Vindaomeo/retropixel/docs/hello_rainbow.gif

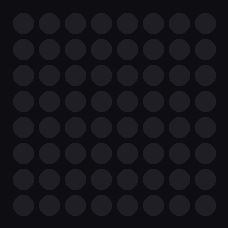
docs/hello_rainbow.gif
