Vindaomeo/retropixel/docs/smiley.gif

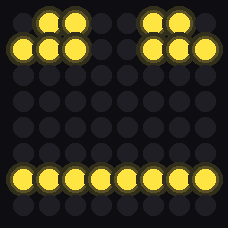
docs/smiley.gif
