Vindaomeo/retropixel/pcb/LED_Matrix_16x16_2L/LED_Matrix_16x16_2L.step

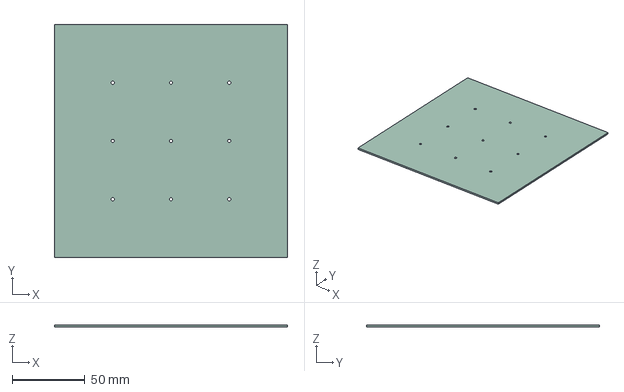
[picture p3: CAD file, 2026-10-02]
pcb/LED_Matrix_16x16_2L/LED_Matrix_16x16_2L.step
160.0 x 160.0 x 1.51 mm
