Vindaomeo/retropixel/pcb/LED_Matrix_16x16_Rahmen.stl

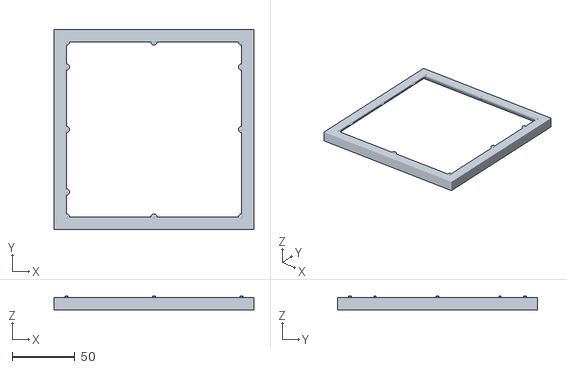
[picture p4: CAD file, 2026-10-02]
pcb/LED_Matrix_16x16_Rahmen.stl
160.0 x 160.0 x 11.4
