Vindaomeo/retropixel/pcb/LED_Matrix_16x16_Lichtgitter.stl

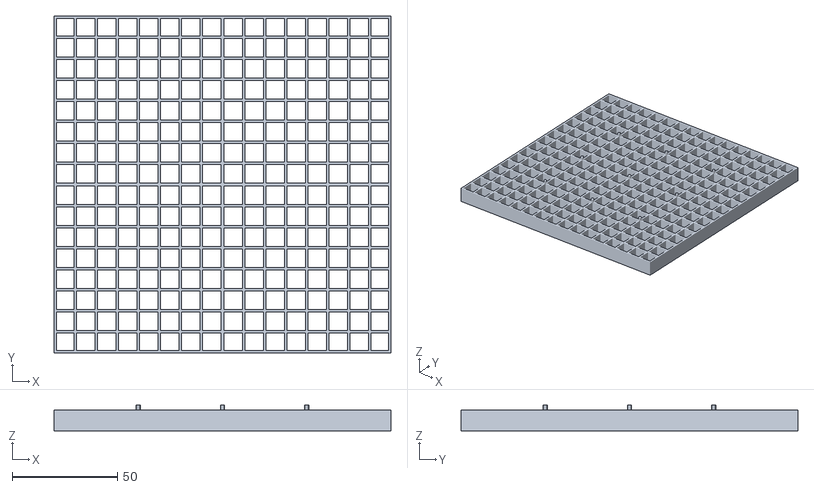
[picture p5: CAD file, 2026-10-02]
pcb/LED_Matrix_16x16_Lichtgitter.stl
160.0 x 160.0 x 12.2
