Vindaomeo/retropixel/pcb/LED_Matrix_16x16_Lichtgitter_Test3x3.stl

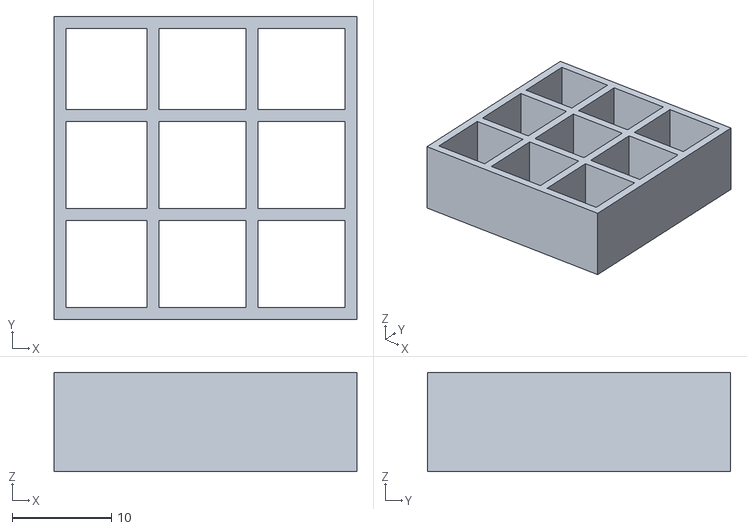
[picture p6: CAD file, 2026-10-02]
pcb/LED_Matrix_16x16_Lichtgitter_Test3x3.stl
30.6 x 30.6 x 10.0
