Vindaomeo/retropixel/pcb/LED_Matrix_16x16_2L/LED_Matrix_16x16_2L.kicad_pcb

## KiCad design pcb/LED_Matrix_16x16_2L/LED_Matrix_16x16_2L.kicad_pcb (2026-10-02)

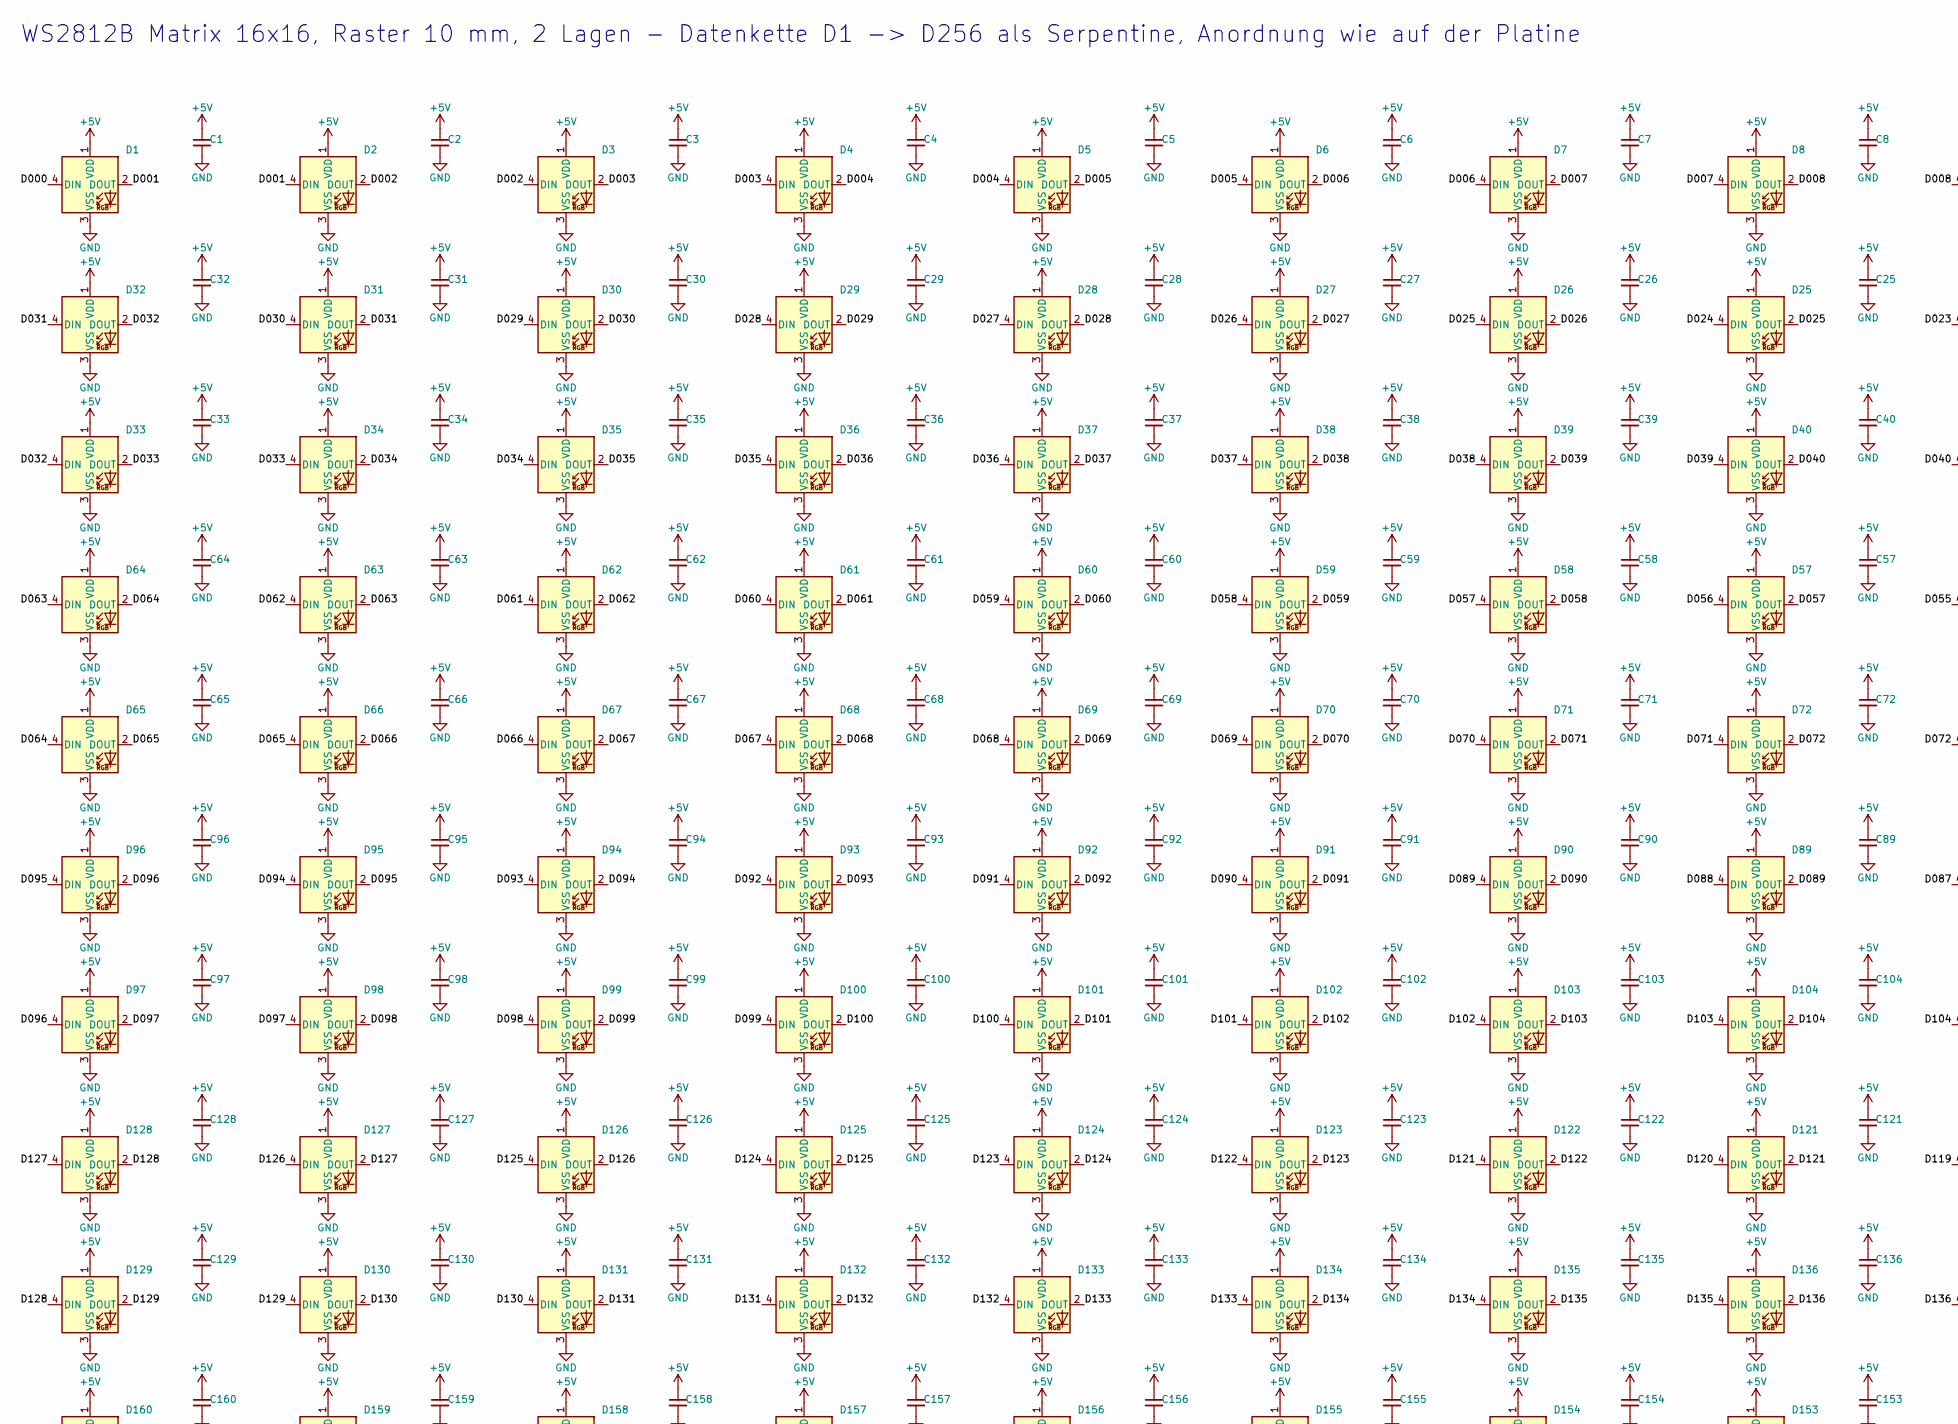
[picture p7: schematic LED_Matrix_16x16_2L.kicad_sch, WS2812B Matrix 16x16, Raster 10 mm, 2 Lagen, part in row 1, column 1]

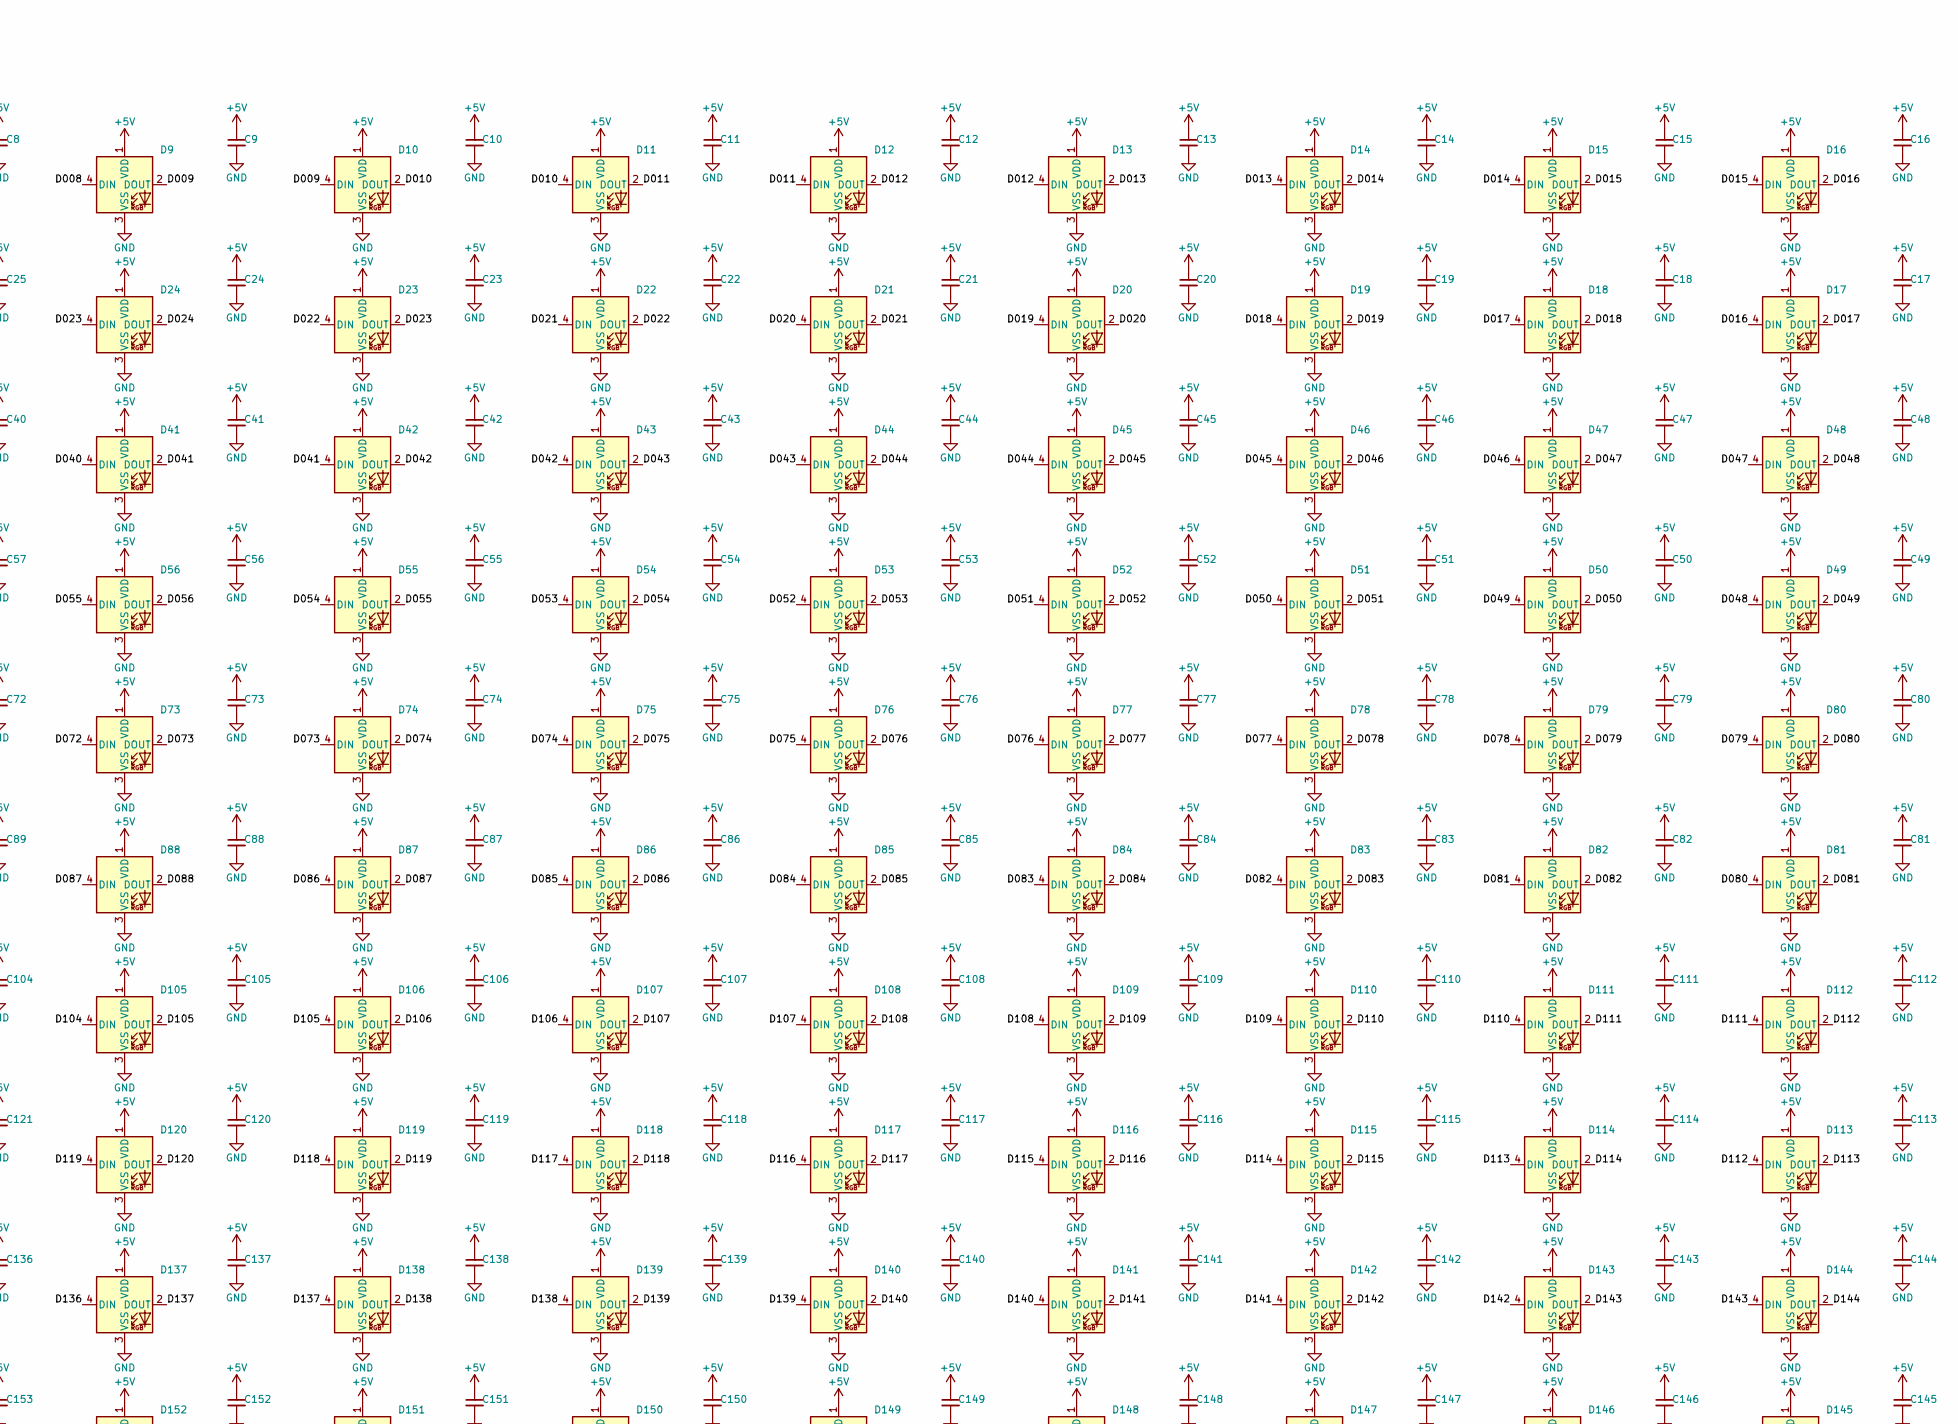
[picture p8: schematic LED_Matrix_16x16_2L.kicad_sch, WS2812B Matrix 16x16, Raster 10 mm, 2 Lagen, part in row 1, column 2]

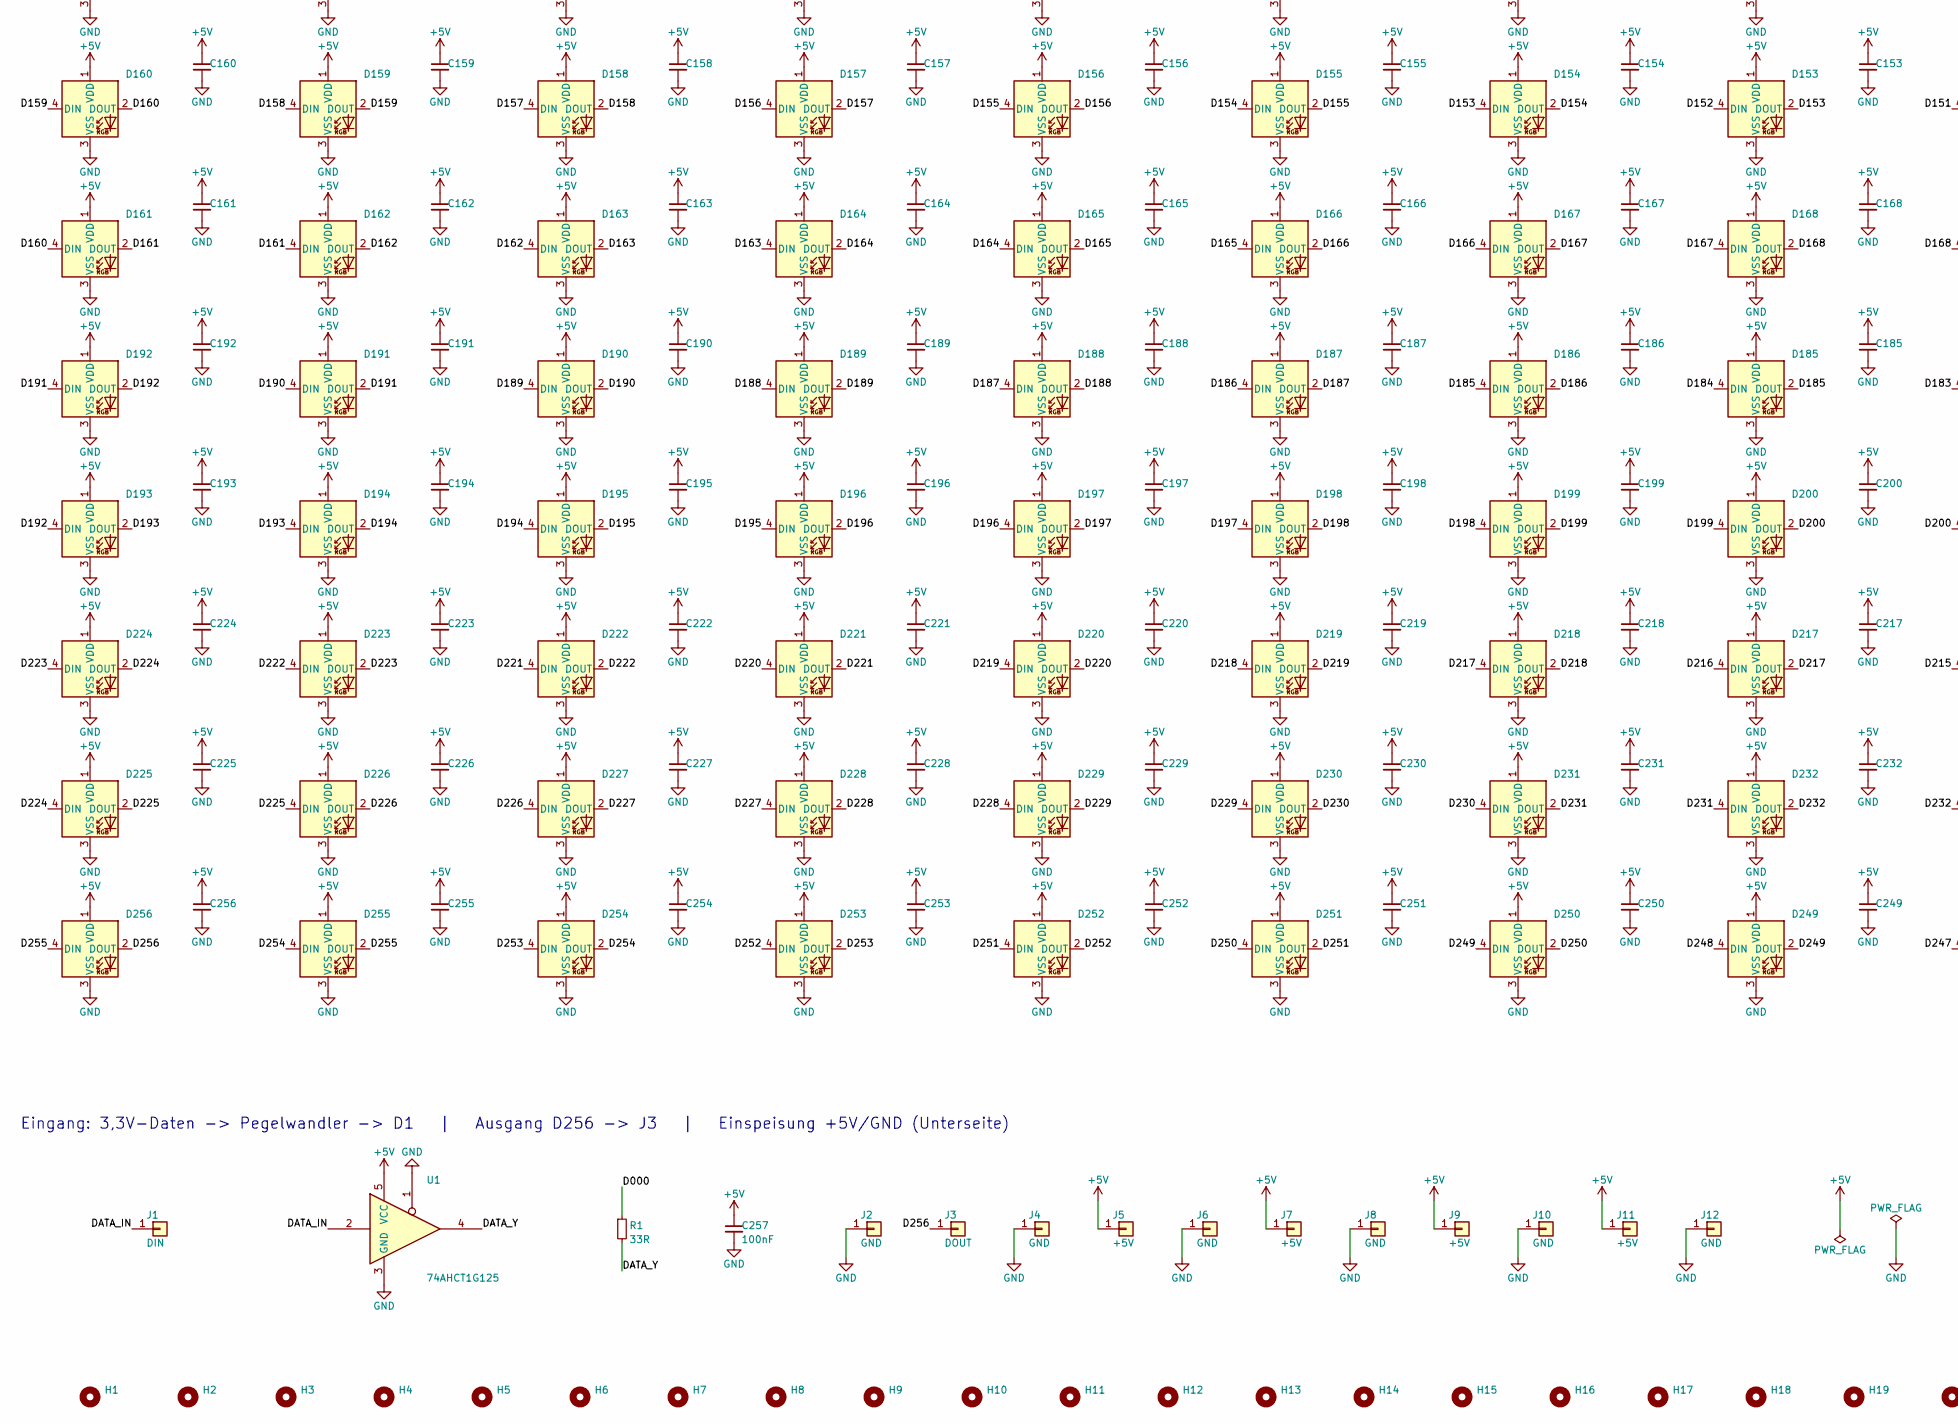
[picture p9: schematic LED_Matrix_16x16_2L.kicad_sch, WS2812B Matrix 16x16, Raster 10 mm, 2 Lagen, part in row 2, column 1]

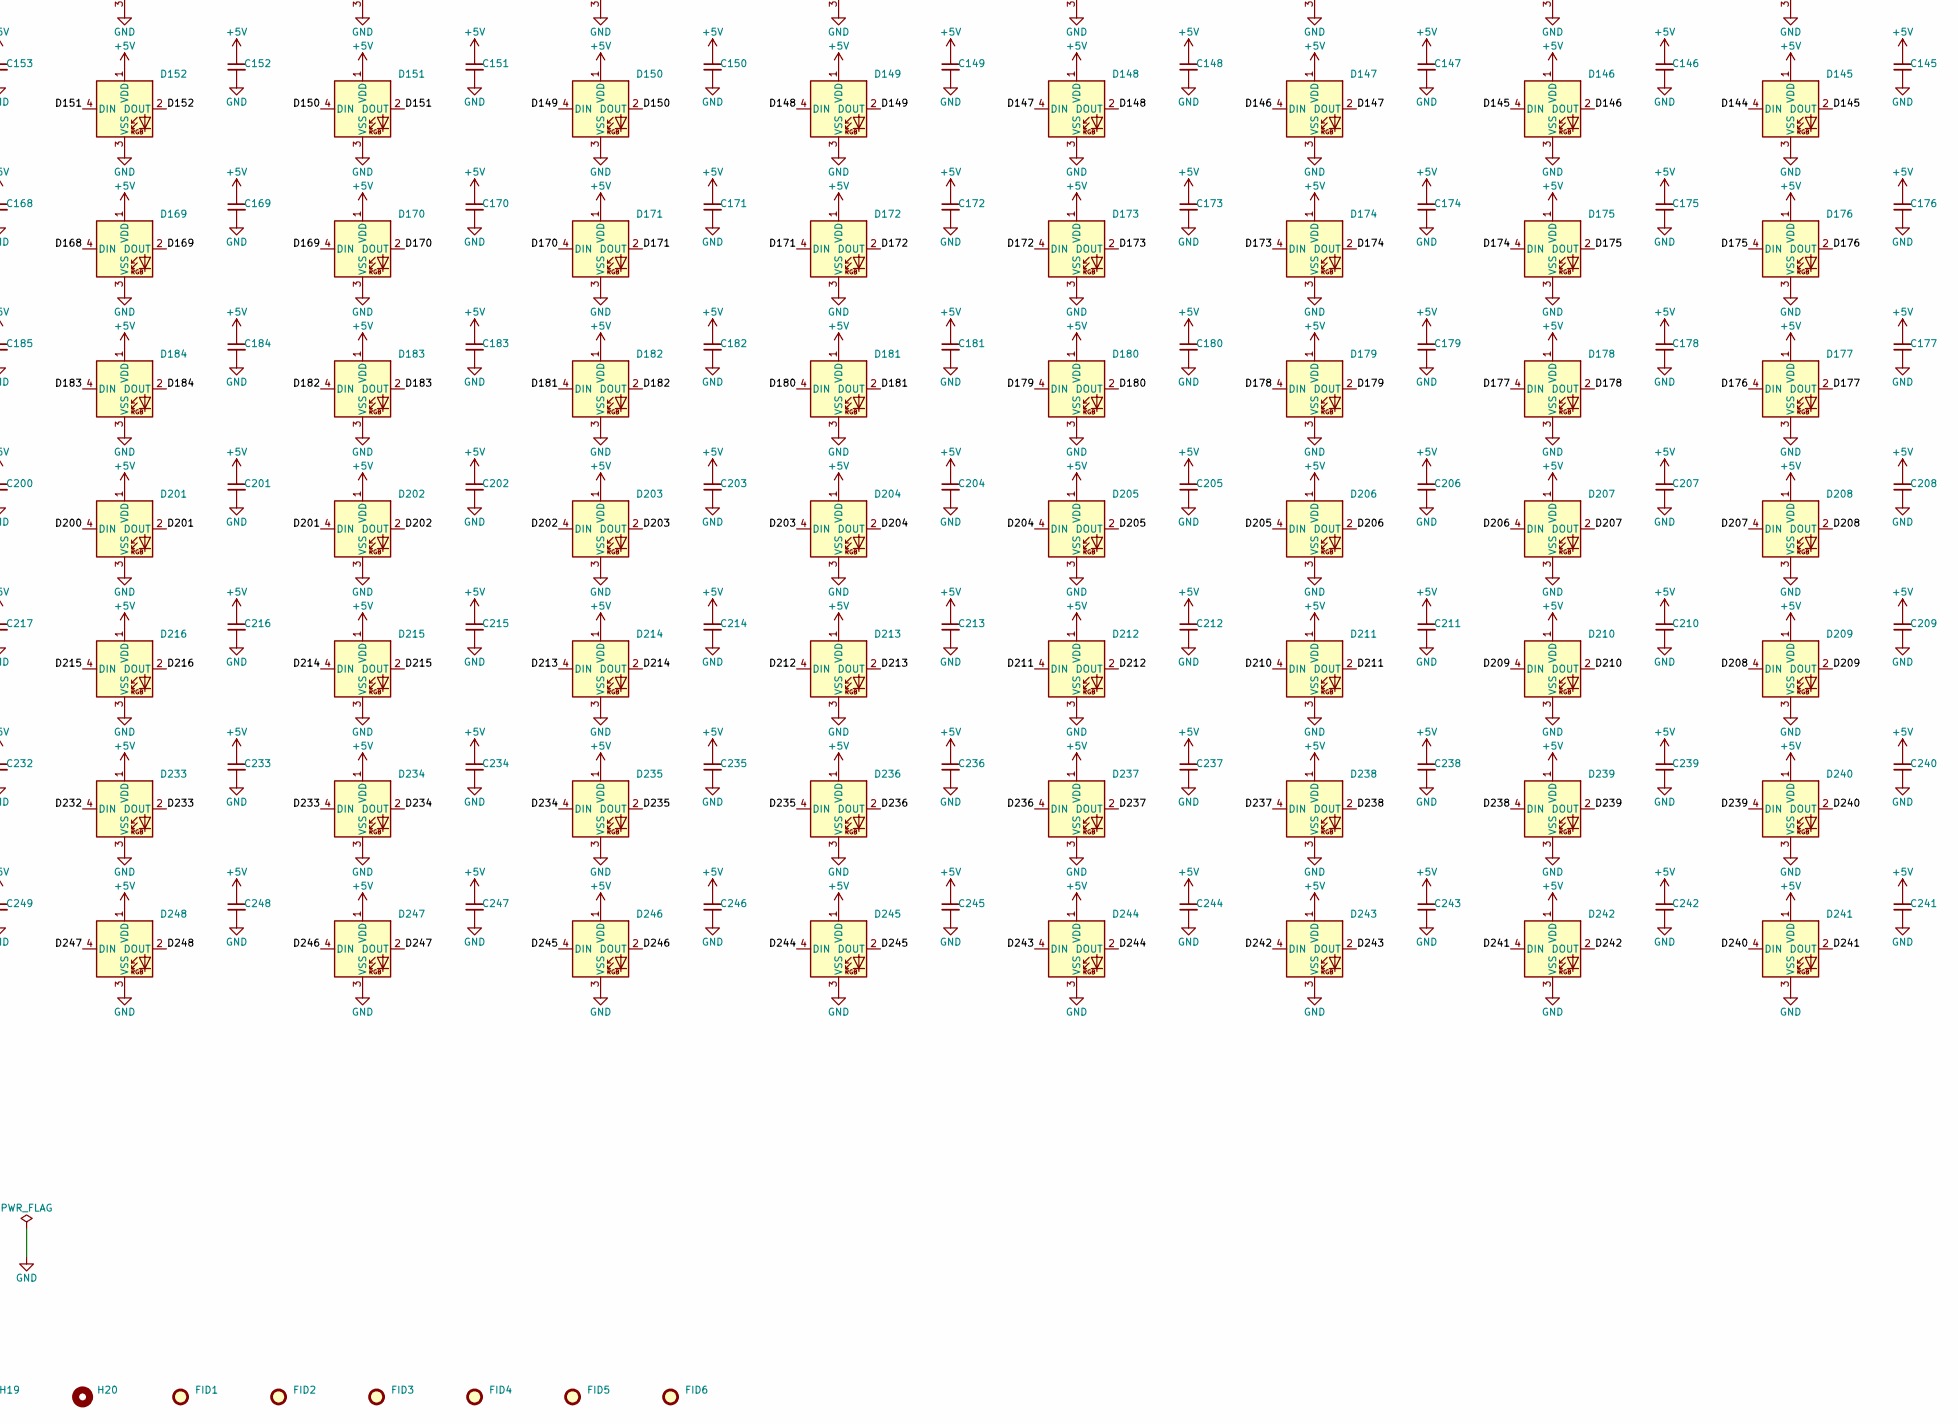
[picture p10: schematic LED_Matrix_16x16_2L.kicad_sch, WS2812B Matrix 16x16, Raster 10 mm, 2 Lagen, part in row 2, column 2]

Parts:
C1, C2, C3, C4, C5, C6, C7, C8, C9, C10, C11, C12, C13, C14, C15, C16, C17, C18, C19, C20, C21, C22, C23, C24, C25, C26, C27, C28, C29, C30, C31, C32, C33, C34, C35, C36, C37, C38, C39, C40, C41, C42, C43, C44, C45, C46, C47, C48, C49, C50, C51, C52, C53, C54, C55, C56, C57, C58, C59, C60, C61, C62, C63, C64, C65, C66, C67, C68, C69, C70, C71, C72, C73, C74, C75, C76, C77, C78, C79, C80, C81, C82, C83, C84, C85, C86, C87, C88, C89, C90, C91, C92, C93, C94, C95, C96, C97, C98, C99, C100, C101, C102, C103, C104, C105, C106, C107, C108, C109, C110, C111, C112, C113, C114, C115, C116, C117, C118, C119, C120, C121, C122, C123, C124, C125, C126, C127, C128, C129, C130, C131, C132, C133, C134, C135, C136, C137, C138, C139, C140, C141, C142, C143, C144, C145, C146, C147, C148, C149, C150, C151, C152, C153, C154, C155, C156, C157, C158, C159, C160, C161, C162, C163, C164, C165, C166, C167, C168, C169, C170, C171, C172, C173, C174, C175, C176, C177, C178, C179, C180, C181, C182, C183, C184, C185, C186, C187, C188, C189, C190, C191, C192, C193, C194, C195, C196, C197, C198, C199, C200, C201, C202, C203, C204, C205, C206, C207, C208, C209, C210, C211, C212, C213, C214, C215, C216, C217, C218, C219, C220, C221, C222, C223, C224, C225, C226, C227, C228, C229, C230, C231, C232, C233, C234, C235, C236, C237, C238, C239, C240, C241, C242, C243, C244, C245, C246, C247, C248, C249, C250, C251, C252, C253, C254, C255, C256, C257: 100nF; C_0402_1005Metric; LCSC C1525
D1, D2, D3, D4, D5, D6, D7, D8, D9, D10, D11, D12, D13, D14, D15, D16, D17, D18, D19, D20, D21, D22, D23, D24, D25, D26, D27, D28, D29, D30, D31, D32, D33, D34, D35, D36, D37, D38, D39, D40, D41, D42, D43, D44, D45, D46, D47, D48, D49, D50, D51, D52, D53, D54, D55, D56, D57, D58, D59, D60, D61, D62, D63, D64, D65, D66, D67, D68, D69, D70, D71, D72, D73, D74, D75, D76, D77, D78, D79, D80, D81, D82, D83, D84, D85, D86, D87, D88, D89, D90, D91, D92, D93, D94, D95, D96, D97, D98, D99, D100, D101, D102, D103, D104, D105, D106, D107, D108, D109, D110, D111, D112, D113, D114, D115, D116, D117, D118, D119, D120, D121, D122, D123, D124, D125, D126, D127, D128, D129, D130, D131, D132, D133, D134, D135, D136, D137, D138, D139, D140, D141, D142, D143, D144, D145, D146, D147, D148, D149, D150, D151, D152, D153, D154, D155, D156, D157, D158, D159, D160, D161, D162, D163, D164, D165, D166, D167, D168, D169, D170, D171, D172, D173, D174, D175, D176, D177, D178, D179, D180, D181, D182, D183, D184, D185, D186, D187, D188, D189, D190, D191, D192, D193, D194, D195, D196, D197, D198, D199, D200, D201, D202, D203, D204, D205, D206, D207, D208, D209, D210, D211, D212, D213, D214, D215, D216, D217, D218, D219, D220, D221, D222, D223, D224, D225, D226, D227, D228, D229, D230, D231, D232, D233, D234, D235, D236, D237, D238, D239, D240, D241, D242, D243, D244, D245, D246, D247, D248, D249, D250, D251, D252, D253, D254, D255, D256: WS2812B; LED_WS2812B_PLCC4_5.0x5.0mm_P3.2mm; LCSC C2843785
FID1, FID2, FID3, FID4, FID5, FID6: Fiducial; Fiducial_1mm_Mask2mm
H1, H2, H3, H4, H5, H6, H7, H8, H9, H10, H11, H12, H13, H14, H15, H16, H17: Hole; NPTH_2.2mm
H18, H19, H20: Locate; NPTH_1.9mm
J1: DIN; SolderPad_3x2mm
J2, J4: GND; SolderPad_3x2mm
J3: DOUT; SolderPad_3x2mm
J5, J7, J9, J11: +5V; SolderPad_3.6x5mm
J6, J8, J10, J12: GND; SolderPad_3.6x5mm
R1: 33R; R_0402_1005Metric; LCSC C25105
U1: 74AHCT1G125; SOT-23-5; LCSC C7484

Connections:
+5V: C1.1, C2.1, C3.1, C4.1, C5.1, C6.1, C7.1, C8.1, C9.1, C10.1, C11.1, C12.1, C13.1, C14.1, C15.1, C16.1, C17.1, C18.1, C19.1, C20.1, C21.1, C22.1, C23.1, C24.1, C25.1, C26.1, C27.1, C28.1, C29.1, C30.1, C31.1, C32.1, C33.1, C34.1, C35.1, C36.1, C37.1, C38.1, C39.1, C40.1, C41.1, C42.1, C43.1, C44.1, C45.1, C46.1, C47.1, C48.1, C49.1, C50.1, C51.1, C52.1, C53.1, C54.1, C55.1, C56.1, C57.1, C58.1, C59.1, C60.1, C61.1, C62.1, C63.1, C64.1, C65.1, C66.1, C67.1, C68.1, C69.1, C70.1, C71.1, C72.1, C73.1, C74.1, C75.1, C76.1, C77.1, C78.1, C79.1, C80.1, C81.1, C82.1, C83.1, C84.1, C85.1, C86.1, C87.1, C88.1, C89.1, C90.1, C91.1, C92.1, C93.1, C94.1, C95.1, C96.1, C97.1, C98.1, C99.1, C100.1, C101.1, C102.1, C103.1, C104.1, C105.1, C106.1, C107.1, C108.1, C109.1, C110.1, C111.1, C112.1, C113.1, C114.1, C115.1, C116.1, C117.1, C118.1, C119.1, C120.1, C121.1, C122.1, C123.1, C124.1, C125.1, C126.1, C127.1, C128.1, C129.1, C130.1, C131.1, C132.1, C133.1, C134.1, C135.1, C136.1, C137.1, C138.1, C139.1, C140.1, C141.1, C142.1, C143.1, C144.1, C145.1, C146.1, C147.1, C148.1, C149.1, C150.1, C151.1, C152.1, C153.1, C154.1, C155.1, C156.1, C157.1, C158.1, C159.1, C160.1, C161.1, C162.1, C163.1, C164.1, C165.1, C166.1, C167.1, C168.1, C169.1, C170.1, C171.1, C172.1, C173.1, C174.1, C175.1, C176.1, C177.1, C178.1, C179.1, C180.1, C181.1, C182.1, C183.1, C184.1, C185.1, C186.1, C187.1, C188.1, C189.1, C190.1, C191.1, C192.1, C193.1, C194.1, C195.1, C196.1, C197.1, C198.1, C199.1, C200.1, C201.1, C202.1, C203.1, C204.1, C205.1, C206.1, C207.1, C208.1, C209.1, C210.1, C211.1, C212.1, C213.1, C214.1, C215.1, C216.1, C217.1, C218.1, C219.1, C220.1, C221.1, C222.1, C223.1, C224.1, C225.1, C226.1, C227.1, C228.1, C229.1, C230.1, C231.1, C232.1, C233.1, C234.1, C235.1, C236.1, C237.1, C238.1, C239.1, C240.1, C241.1, C242.1, C243.1, C244.1, C245.1, C246.1, C247.1, C248.1, C249.1, C250.1, C251.1, C252.1, C253.1, C254.1, C255.1, C256.1, C257.1, D1.1 (VDD), D2.1 (VDD), D3.1 (VDD), D4.1 (VDD), D5.1 (VDD), D6.1 (VDD), D7.1 (VDD), D8.1 (VDD), D9.1 (VDD), D10.1 (VDD), D11.1 (VDD), D12.1 (VDD), D13.1 (VDD), D14.1 (VDD), D15.1 (VDD), D16.1 (VDD), D17.1 (VDD), D18.1 (VDD), D19.1 (VDD), D20.1 (VDD), D21.1 (VDD), D22.1 (VDD), D23.1 (VDD), D24.1 (VDD), D25.1 (VDD), D26.1 (VDD), D27.1 (VDD), D28.1 (VDD), D29.1 (VDD), D30.1 (VDD), D31.1 (VDD), D32.1 (VDD), D33.1 (VDD), D34.1 (VDD), D35.1 (VDD), D36.1 (VDD), D37.1 (VDD), D38.1 (VDD), D39.1 (VDD), D40.1 (VDD), D41.1 (VDD), D42.1 (VDD), D43.1 (VDD), D44.1 (VDD), D45.1 (VDD), D46.1 (VDD), D47.1 (VDD), D48.1 (VDD), D49.1 (VDD), D50.1 (VDD), D51.1 (VDD), D52.1 (VDD), D53.1 (VDD), D54.1 (VDD), D55.1 (VDD), D56.1 (VDD), D57.1 (VDD), D58.1 (VDD), D59.1 (VDD), D60.1 (VDD), D61.1 (VDD), D62.1 (VDD), D63.1 (VDD), D64.1 (VDD), D65.1 (VDD), D66.1 (VDD), D67.1 (VDD), D68.1 (VDD), D69.1 (VDD), D70.1 (VDD), D71.1 (VDD), D72.1 (VDD), D73.1 (VDD), D74.1 (VDD), D75.1 (VDD), D76.1 (VDD), D77.1 (VDD), D78.1 (VDD), D79.1 (VDD), D80.1 (VDD), D81.1 (VDD), D82.1 (VDD), D83.1 (VDD), D84.1 (VDD), D85.1 (VDD), D86.1 (VDD), D87.1 (VDD), D88.1 (VDD), D89.1 (VDD), D90.1 (VDD), D91.1 (VDD), D92.1 (VDD), D93.1 (VDD), D94.1 (VDD), D95.1 (VDD), D96.1 (VDD), D97.1 (VDD), D98.1 (VDD), D99.1 (VDD), D100.1 (VDD), D101.1 (VDD), D102.1 (VDD), D103.1 (VDD), D104.1 (VDD), D105.1 (VDD), D106.1 (VDD), D107.1 (VDD), D108.1 (VDD), D109.1 (VDD), D110.1 (VDD), D111.1 (VDD), D112.1 (VDD), D113.1 (VDD), D114.1 (VDD), D115.1 (VDD), D116.1 (VDD), D117.1 (VDD), D118.1 (VDD), D119.1 (VDD), D120.1 (VDD), D121.1 (VDD), D122.1 (VDD), D123.1 (VDD), D124.1 (VDD), D125.1 (VDD), D126.1 (VDD), D127.1 (VDD), D128.1 (VDD), D129.1 (VDD), D130.1 (VDD), D131.1 (VDD), D132.1 (VDD), D133.1 (VDD), D134.1 (VDD), D135.1 (VDD), D136.1 (VDD), D137.1 (VDD), D138.1 (VDD), D139.1 (VDD), D140.1 (VDD), D141.1 (VDD), D142.1 (VDD), D143.1 (VDD), D144.1 (VDD), D145.1 (VDD), D146.1 (VDD), D147.1 (VDD), D148.1 (VDD), D149.1 (VDD), D150.1 (VDD), D151.1 (VDD), D152.1 (VDD), D153.1 (VDD), D154.1 (VDD), D155.1 (VDD), D156.1 (VDD), D157.1 (VDD), D158.1 (VDD), D159.1 (VDD), D160.1 (VDD), D161.1 (VDD), D162.1 (VDD), D163.1 (VDD), D164.1 (VDD), D165.1 (VDD), D166.1 (VDD), D167.1 (VDD), D168.1 (VDD), D169.1 (VDD), D170.1 (VDD), D171.1 (VDD), D172.1 (VDD), D173.1 (VDD), D174.1 (VDD), D175.1 (VDD), D176.1 (VDD), D177.1 (VDD), D178.1 (VDD), D179.1 (VDD), D180.1 (VDD), D181.1 (VDD), D182.1 (VDD), D183.1 (VDD), D184.1 (VDD), D185.1 (VDD), D186.1 (VDD), D187.1 (VDD), D188.1 (VDD), D189.1 (VDD), D190.1 (VDD), D191.1 (VDD), D192.1 (VDD), D193.1 (VDD), D194.1 (VDD), D195.1 (VDD), D196.1 (VDD), D197.1 (VDD), D198.1 (VDD), D199.1 (VDD), D200.1 (VDD), D201.1 (VDD), D202.1 (VDD), D203.1 (VDD), D204.1 (VDD), D205.1 (VDD), D206.1 (VDD), D207.1 (VDD), D208.1 (VDD), D209.1 (VDD), D210.1 (VDD), D211.1 (VDD), D212.1 (VDD), D213.1 (VDD), D214.1 (VDD), D215.1 (VDD), D216.1 (VDD), D217.1 (VDD), D218.1 (VDD), D219.1 (VDD), D220.1 (VDD), D221.1 (VDD), D222.1 (VDD), D223.1 (VDD), D224.1 (VDD), D225.1 (VDD), D226.1 (VDD), D227.1 (VDD), D228.1 (VDD), D229.1 (VDD), D230.1 (VDD), D231.1 (VDD), D232.1 (VDD), D233.1 (VDD), D234.1 (VDD), D235.1 (VDD), D236.1 (VDD), D237.1 (VDD), D238.1 (VDD), D239.1 (VDD), D240.1 (VDD), D241.1 (VDD), D242.1 (VDD), D243.1 (VDD), D244.1 (VDD), D245.1 (VDD), D246.1 (VDD), D247.1 (VDD), D248.1 (VDD), D249.1 (VDD), D250.1 (VDD), D251.1 (VDD), D252.1 (VDD), D253.1 (VDD), D254.1 (VDD), D255.1 (VDD), D256.1 (VDD), J5.1, J7.1, J9.1, J11.1, U1.5 (VCC)
/D000: D1.4 (DIN), R1.1
/D001: D1.2 (DOUT), D2.4 (DIN)
/D002: D2.2 (DOUT), D3.4 (DIN)
/D003: D3.2 (DOUT), D4.4 (DIN)
/D004: D4.2 (DOUT), D5.4 (DIN)
/D005: D5.2 (DOUT), D6.4 (DIN)
/D006: D6.2 (DOUT), D7.4 (DIN)
/D007: D7.2 (DOUT), D8.4 (DIN)
/D008: D8.2 (DOUT), D9.4 (DIN)
/D009: D9.2 (DOUT), D10.4 (DIN)
/D010: D10.2 (DOUT), D11.4 (DIN)
/D011: D11.2 (DOUT), D12.4 (DIN)
/D012: D12.2 (DOUT), D13.4 (DIN)
/D013: D13.2 (DOUT), D14.4 (DIN)
/D014: D14.2 (DOUT), D15.4 (DIN)
/D015: D15.2 (DOUT), D16.4 (DIN)
/D016: D16.2 (DOUT), D17.4 (DIN)
/D017: D17.2 (DOUT), D18.4 (DIN)
/D018: D18.2 (DOUT), D19.4 (DIN)
/D019: D19.2 (DOUT), D20.4 (DIN)
/D020: D20.2 (DOUT), D21.4 (DIN)
/D021: D21.2 (DOUT), D22.4 (DIN)
/D022: D22.2 (DOUT), D23.4 (DIN)
/D023: D23.2 (DOUT), D24.4 (DIN)
/D024: D24.2 (DOUT), D25.4 (DIN)
/D025: D25.2 (DOUT), D26.4 (DIN)
/D026: D26.2 (DOUT), D27.4 (DIN)
/D027: D27.2 (DOUT), D28.4 (DIN)
/D028: D28.2 (DOUT), D29.4 (DIN)
/D029: D29.2 (DOUT), D30.4 (DIN)
/D030: D30.2 (DOUT), D31.4 (DIN)
/D031: D31.2 (DOUT), D32.4 (DIN)
/D032: D32.2 (DOUT), D33.4 (DIN)
/D033: D33.2 (DOUT), D34.4 (DIN)
/D034: D34.2 (DOUT), D35.4 (DIN)
/D035: D35.2 (DOUT), D36.4 (DIN)
/D036: D36.2 (DOUT), D37.4 (DIN)
/D037: D37.2 (DOUT), D38.4 (DIN)
/D038: D38.2 (DOUT), D39.4 (DIN)
/D039: D39.2 (DOUT), D40.4 (DIN)
/D040: D40.2 (DOUT), D41.4 (DIN)
/D041: D41.2 (DOUT), D42.4 (DIN)
/D042: D42.2 (DOUT), D43.4 (DIN)
/D043: D43.2 (DOUT), D44.4 (DIN)
/D044: D44.2 (DOUT), D45.4 (DIN)
/D045: D45.2 (DOUT), D46.4 (DIN)
/D046: D46.2 (DOUT), D47.4 (DIN)
/D047: D47.2 (DOUT), D48.4 (DIN)
/D048: D48.2 (DOUT), D49.4 (DIN)
/D049: D49.2 (DOUT), D50.4 (DIN)
/D050: D50.2 (DOUT), D51.4 (DIN)
/D051: D51.2 (DOUT), D52.4 (DIN)
/D052: D52.2 (DOUT), D53.4 (DIN)
/D053: D53.2 (DOUT), D54.4 (DIN)
/D054: D54.2 (DOUT), D55.4 (DIN)
/D055: D55.2 (DOUT), D56.4 (DIN)
/D056: D56.2 (DOUT), D57.4 (DIN)
/D057: D57.2 (DOUT), D58.4 (DIN)
/D058: D58.2 (DOUT), D59.4 (DIN)
/D059: D59.2 (DOUT), D60.4 (DIN)
/D060: D60.2 (DOUT), D61.4 (DIN)
/D061: D61.2 (DOUT), D62.4 (DIN)
/D062: D62.2 (DOUT), D63.4 (DIN)
/D063: D63.2 (DOUT), D64.4 (DIN)
/D064: D64.2 (DOUT), D65.4 (DIN)
/D065: D65.2 (DOUT), D66.4 (DIN)
/D066: D66.2 (DOUT), D67.4 (DIN)
/D067: D67.2 (DOUT), D68.4 (DIN)
/D068: D68.2 (DOUT), D69.4 (DIN)
/D069: D69.2 (DOUT), D70.4 (DIN)
/D070: D70.2 (DOUT), D71.4 (DIN)
/D071: D71.2 (DOUT), D72.4 (DIN)
/D072: D72.2 (DOUT), D73.4 (DIN)
/D073: D73.2 (DOUT), D74.4 (DIN)
/D074: D74.2 (DOUT), D75.4 (DIN)
/D075: D75.2 (DOUT), D76.4 (DIN)
/D076: D76.2 (DOUT), D77.4 (DIN)
/D077: D77.2 (DOUT), D78.4 (DIN)
/D078: D78.2 (DOUT), D79.4 (DIN)
/D079: D79.2 (DOUT), D80.4 (DIN)
/D080: D80.2 (DOUT), D81.4 (DIN)
/D081: D81.2 (DOUT), D82.4 (DIN)
/D082: D82.2 (DOUT), D83.4 (DIN)
/D083: D83.2 (DOUT), D84.4 (DIN)
/D084: D84.2 (DOUT), D85.4 (DIN)
/D085: D85.2 (DOUT), D86.4 (DIN)
/D086: D86.2 (DOUT), D87.4 (DIN)
/D087: D87.2 (DOUT), D88.4 (DIN)
/D088: D88.2 (DOUT), D89.4 (DIN)
/D089: D89.2 (DOUT), D90.4 (DIN)
/D090: D90.2 (DOUT), D91.4 (DIN)
/D091: D91.2 (DOUT), D92.4 (DIN)
/D092: D92.2 (DOUT), D93.4 (DIN)
/D093: D93.2 (DOUT), D94.4 (DIN)
/D094: D94.2 (DOUT), D95.4 (DIN)
/D095: D95.2 (DOUT), D96.4 (DIN)
/D096: D96.2 (DOUT), D97.4 (DIN)
/D097: D97.2 (DOUT), D98.4 (DIN)
/D098: D98.2 (DOUT), D99.4 (DIN)
/D099: D99.2 (DOUT), D100.4 (DIN)
/D100: D100.2 (DOUT), D101.4 (DIN)
/D101: D101.2 (DOUT), D102.4 (DIN)
/D102: D102.2 (DOUT), D103.4 (DIN)
/D103: D103.2 (DOUT), D104.4 (DIN)
/D104: D104.2 (DOUT), D105.4 (DIN)
/D105: D105.2 (DOUT), D106.4 (DIN)
/D106: D106.2 (DOUT), D107.4 (DIN)
/D107: D107.2 (DOUT), D108.4 (DIN)
/D108: D108.2 (DOUT), D109.4 (DIN)
/D109: D109.2 (DOUT), D110.4 (DIN)
/D110: D110.2 (DOUT), D111.4 (DIN)
/D111: D111.2 (DOUT), D112.4 (DIN)
/D112: D112.2 (DOUT), D113.4 (DIN)
/D113: D113.2 (DOUT), D114.4 (DIN)
/D114: D114.2 (DOUT), D115.4 (DIN)
/D115: D115.2 (DOUT), D116.4 (DIN)
/D116: D116.2 (DOUT), D117.4 (DIN)
/D117: D117.2 (DOUT), D118.4 (DIN)
/D118: D118.2 (DOUT), D119.4 (DIN)
/D119: D119.2 (DOUT), D120.4 (DIN)
/D120: D120.2 (DOUT), D121.4 (DIN)
/D121: D121.2 (DOUT), D122.4 (DIN)
/D122: D122.2 (DOUT), D123.4 (DIN)
/D123: D123.2 (DOUT), D124.4 (DIN)
/D124: D124.2 (DOUT), D125.4 (DIN)
/D125: D125.2 (DOUT), D126.4 (DIN)
/D126: D126.2 (DOUT), D127.4 (DIN)
/D127: D127.2 (DOUT), D128.4 (DIN)
/D128: D128.2 (DOUT), D129.4 (DIN)
/D129: D129.2 (DOUT), D130.4 (DIN)
/D130: D130.2 (DOUT), D131.4 (DIN)
/D131: D131.2 (DOUT), D132.4 (DIN)
/D132: D132.2 (DOUT), D133.4 (DIN)
/D133: D133.2 (DOUT), D134.4 (DIN)
/D134: D134.2 (DOUT), D135.4 (DIN)
/D135: D135.2 (DOUT), D136.4 (DIN)
/D136: D136.2 (DOUT), D137.4 (DIN)
/D137: D137.2 (DOUT), D138.4 (DIN)
/D138: D138.2 (DOUT), D139.4 (DIN)
/D139: D139.2 (DOUT), D140.4 (DIN)
/D140: D140.2 (DOUT), D141.4 (DIN)
/D141: D141.2 (DOUT), D142.4 (DIN)
/D142: D142.2 (DOUT), D143.4 (DIN)
/D143: D143.2 (DOUT), D144.4 (DIN)
/D144: D144.2 (DOUT), D145.4 (DIN)
/D145: D145.2 (DOUT), D146.4 (DIN)
/D146: D146.2 (DOUT), D147.4 (DIN)
/D147: D147.2 (DOUT), D148.4 (DIN)
/D148: D148.2 (DOUT), D149.4 (DIN)
/D149: D149.2 (DOUT), D150.4 (DIN)
/D150: D150.2 (DOUT), D151.4 (DIN)
/D151: D151.2 (DOUT), D152.4 (DIN)
/D152: D152.2 (DOUT), D153.4 (DIN)
/D153: D153.2 (DOUT), D154.4 (DIN)
/D154: D154.2 (DOUT), D155.4 (DIN)
/D155: D155.2 (DOUT), D156.4 (DIN)
/D156: D156.2 (DOUT), D157.4 (DIN)
/D157: D157.2 (DOUT), D158.4 (DIN)
/D158: D158.2 (DOUT), D159.4 (DIN)
/D159: D159.2 (DOUT), D160.4 (DIN)
/D160: D160.2 (DOUT), D161.4 (DIN)
/D161: D161.2 (DOUT), D162.4 (DIN)
/D162: D162.2 (DOUT), D163.4 (DIN)
/D163: D163.2 (DOUT), D164.4 (DIN)
/D164: D164.2 (DOUT), D165.4 (DIN)
/D165: D165.2 (DOUT), D166.4 (DIN)
/D166: D166.2 (DOUT), D167.4 (DIN)
/D167: D167.2 (DOUT), D168.4 (DIN)
/D168: D168.2 (DOUT), D169.4 (DIN)
/D169: D169.2 (DOUT), D170.4 (DIN)
/D170: D170.2 (DOUT), D171.4 (DIN)
/D171: D171.2 (DOUT), D172.4 (DIN)
/D172: D172.2 (DOUT), D173.4 (DIN)
/D173: D173.2 (DOUT), D174.4 (DIN)
/D174: D174.2 (DOUT), D175.4 (DIN)
/D175: D175.2 (DOUT), D176.4 (DIN)
/D176: D176.2 (DOUT), D177.4 (DIN)
/D177: D177.2 (DOUT), D178.4 (DIN)
/D178: D178.2 (DOUT), D179.4 (DIN)
/D179: D179.2 (DOUT), D180.4 (DIN)
/D180: D180.2 (DOUT), D181.4 (DIN)
/D181: D181.2 (DOUT), D182.4 (DIN)
/D182: D182.2 (DOUT), D183.4 (DIN)
/D183: D183.2 (DOUT), D184.4 (DIN)
/D184: D184.2 (DOUT), D185.4 (DIN)
/D185: D185.2 (DOUT), D186.4 (DIN)
/D186: D186.2 (DOUT), D187.4 (DIN)
/D187: D187.2 (DOUT), D188.4 (DIN)
/D188: D188.2 (DOUT), D189.4 (DIN)
/D189: D189.2 (DOUT), D190.4 (DIN)
/D190: D190.2 (DOUT), D191.4 (DIN)
/D191: D191.2 (DOUT), D192.4 (DIN)
/D192: D192.2 (DOUT), D193.4 (DIN)
/D193: D193.2 (DOUT), D194.4 (DIN)
/D194: D194.2 (DOUT), D195.4 (DIN)
/D195: D195.2 (DOUT), D196.4 (DIN)
/D196: D196.2 (DOUT), D197.4 (DIN)
/D197: D197.2 (DOUT), D198.4 (DIN)
/D198: D198.2 (DOUT), D199.4 (DIN)
/D199: D199.2 (DOUT), D200.4 (DIN)
/D200: D200.2 (DOUT), D201.4 (DIN)
/D201: D201.2 (DOUT), D202.4 (DIN)
/D202: D202.2 (DOUT), D203.4 (DIN)
/D203: D203.2 (DOUT), D204.4 (DIN)
/D204: D204.2 (DOUT), D205.4 (DIN)
/D205: D205.2 (DOUT), D206.4 (DIN)
/D206: D206.2 (DOUT), D207.4 (DIN)
/D207: D207.2 (DOUT), D208.4 (DIN)
/D208: D208.2 (DOUT), D209.4 (DIN)
/D209: D209.2 (DOUT), D210.4 (DIN)
/D210: D210.2 (DOUT), D211.4 (DIN)
/D211: D211.2 (DOUT), D212.4 (DIN)
/D212: D212.2 (DOUT), D213.4 (DIN)
/D213: D213.2 (DOUT), D214.4 (DIN)
/D214: D214.2 (DOUT), D215.4 (DIN)
/D215: D215.2 (DOUT), D216.4 (DIN)
/D216: D216.2 (DOUT), D217.4 (DIN)
/D217: D217.2 (DOUT), D218.4 (DIN)
/D218: D218.2 (DOUT), D219.4 (DIN)
/D219: D219.2 (DOUT), D220.4 (DIN)
/D220: D220.2 (DOUT), D221.4 (DIN)
/D221: D221.2 (DOUT), D222.4 (DIN)
/D222: D222.2 (DOUT), D223.4 (DIN)
/D223: D223.2 (DOUT), D224.4 (DIN)
/D224: D224.2 (DOUT), D225.4 (DIN)
/D225: D225.2 (DOUT), D226.4 (DIN)
/D226: D226.2 (DOUT), D227.4 (DIN)
/D227: D227.2 (DOUT), D228.4 (DIN)
/D228: D228.2 (DOUT), D229.4 (DIN)
/D229: D229.2 (DOUT), D230.4 (DIN)
/D230: D230.2 (DOUT), D231.4 (DIN)
/D231: D231.2 (DOUT), D232.4 (DIN)
/D232: D232.2 (DOUT), D233.4 (DIN)
/D233: D233.2 (DOUT), D234.4 (DIN)
/D234: D234.2 (DOUT), D235.4 (DIN)
/D235: D235.2 (DOUT), D236.4 (DIN)
/D236: D236.2 (DOUT), D237.4 (DIN)
/D237: D237.2 (DOUT), D238.4 (DIN)
/D238: D238.2 (DOUT), D239.4 (DIN)
/D239: D239.2 (DOUT), D240.4 (DIN)
/D240: D240.2 (DOUT), D241.4 (DIN)
/D241: D241.2 (DOUT), D242.4 (DIN)
/D242: D242.2 (DOUT), D243.4 (DIN)
/D243: D243.2 (DOUT), D244.4 (DIN)
/D244: D244.2 (DOUT), D245.4 (DIN)
/D245: D245.2 (DOUT), D246.4 (DIN)
/D246: D246.2 (DOUT), D247.4 (DIN)
/D247: D247.2 (DOUT), D248.4 (DIN)
/D248: D248.2 (DOUT), D249.4 (DIN)
/D249: D249.2 (DOUT), D250.4 (DIN)
/D250: D250.2 (DOUT), D251.4 (DIN)
/D251: D251.2 (DOUT), D252.4 (DIN)
/D252: D252.2 (DOUT), D253.4 (DIN)
/D253: D253.2 (DOUT), D254.4 (DIN)
/D254: D254.2 (DOUT), D255.4 (DIN)
/D255: D255.2 (DOUT), D256.4 (DIN)
/D256: D256.2 (DOUT), J3.1
/DATA_IN: J1.1, U1.2
/DATA_Y: R1.2, U1.4
GND: C1.2, C2.2, C3.2, C4.2, C5.2, C6.2, C7.2, C8.2, C9.2, C10.2, C11.2, C12.2, C13.2, C14.2, C15.2, C16.2, C17.2, C18.2, C19.2, C20.2, C21.2, C22.2, C23.2, C24.2, C25.2, C26.2, C27.2, C28.2, C29.2, C30.2, C31.2, C32.2, C33.2, C34.2, C35.2, C36.2, C37.2, C38.2, C39.2, C40.2, C41.2, C42.2, C43.2, C44.2, C45.2, C46.2, C47.2, C48.2, C49.2, C50.2, C51.2, C52.2, C53.2, C54.2, C55.2, C56.2, C57.2, C58.2, C59.2, C60.2, C61.2, C62.2, C63.2, C64.2, C65.2, C66.2, C67.2, C68.2, C69.2, C70.2, C71.2, C72.2, C73.2, C74.2, C75.2, C76.2, C77.2, C78.2, C79.2, C80.2, C81.2, C82.2, C83.2, C84.2, C85.2, C86.2, C87.2, C88.2, C89.2, C90.2, C91.2, C92.2, C93.2, C94.2, C95.2, C96.2, C97.2, C98.2, C99.2, C100.2, C101.2, C102.2, C103.2, C104.2, C105.2, C106.2, C107.2, C108.2, C109.2, C110.2, C111.2, C112.2, C113.2, C114.2, C115.2, C116.2, C117.2, C118.2, C119.2, C120.2, C121.2, C122.2, C123.2, C124.2, C125.2, C126.2, C127.2, C128.2, C129.2, C130.2, C131.2, C132.2, C133.2, C134.2, C135.2, C136.2, C137.2, C138.2, C139.2, C140.2, C141.2, C142.2, C143.2, C144.2, C145.2, C146.2, C147.2, C148.2, C149.2, C150.2, C151.2, C152.2, C153.2, C154.2, C155.2, C156.2, C157.2, C158.2, C159.2, C160.2, C161.2, C162.2, C163.2, C164.2, C165.2, C166.2, C167.2, C168.2, C169.2, C170.2, C171.2, C172.2, C173.2, C174.2, C175.2, C176.2, C177.2, C178.2, C179.2, C180.2, C181.2, C182.2, C183.2, C184.2, C185.2, C186.2, C187.2, C188.2, C189.2, C190.2, C191.2, C192.2, C193.2, C194.2, C195.2, C196.2, C197.2, C198.2, C199.2, C200.2, C201.2, C202.2, C203.2, C204.2, C205.2, C206.2, C207.2, C208.2, C209.2, C210.2, C211.2, C212.2, C213.2, C214.2, C215.2, C216.2, C217.2, C218.2, C219.2, C220.2, C221.2, C222.2, C223.2, C224.2, C225.2, C226.2, C227.2, C228.2, C229.2, C230.2, C231.2, C232.2, C233.2, C234.2, C235.2, C236.2, C237.2, C238.2, C239.2, C240.2, C241.2, C242.2, C243.2, C244.2, C245.2, C246.2, C247.2, C248.2, C249.2, C250.2, C251.2, C252.2, C253.2, C254.2, C255.2, C256.2, C257.2, D1.3 (VSS), D2.3 (VSS), D3.3 (VSS), D4.3 (VSS), D5.3 (VSS), D6.3 (VSS), D7.3 (VSS), D8.3 (VSS), D9.3 (VSS), D10.3 (VSS), D11.3 (VSS), D12.3 (VSS), D13.3 (VSS), D14.3 (VSS), D15.3 (VSS), D16.3 (VSS), D17.3 (VSS), D18.3 (VSS), D19.3 (VSS), D20.3 (VSS), D21.3 (VSS), D22.3 (VSS), D23.3 (VSS), D24.3 (VSS), D25.3 (VSS), D26.3 (VSS), D27.3 (VSS), D28.3 (VSS), D29.3 (VSS), D30.3 (VSS), D31.3 (VSS), D32.3 (VSS), D33.3 (VSS), D34.3 (VSS), D35.3 (VSS), D36.3 (VSS), D37.3 (VSS), D38.3 (VSS), D39.3 (VSS), D40.3 (VSS), D41.3 (VSS), D42.3 (VSS), D43.3 (VSS), D44.3 (VSS), D45.3 (VSS), D46.3 (VSS), D47.3 (VSS), D48.3 (VSS), D49.3 (VSS), D50.3 (VSS), D51.3 (VSS), D52.3 (VSS), D53.3 (VSS), D54.3 (VSS), D55.3 (VSS), D56.3 (VSS), D57.3 (VSS), D58.3 (VSS), D59.3 (VSS), D60.3 (VSS), D61.3 (VSS), D62.3 (VSS), D63.3 (VSS), D64.3 (VSS), D65.3 (VSS), D66.3 (VSS), D67.3 (VSS), D68.3 (VSS), D69.3 (VSS), D70.3 (VSS), D71.3 (VSS), D72.3 (VSS), D73.3 (VSS), D74.3 (VSS), D75.3 (VSS), D76.3 (VSS), D77.3 (VSS), D78.3 (VSS), D79.3 (VSS), D80.3 (VSS), D81.3 (VSS), D82.3 (VSS), D83.3 (VSS), D84.3 (VSS), D85.3 (VSS), D86.3 (VSS), D87.3 (VSS), D88.3 (VSS), D89.3 (VSS), D90.3 (VSS), D91.3 (VSS), D92.3 (VSS), D93.3 (VSS), D94.3 (VSS), D95.3 (VSS), D96.3 (VSS), D97.3 (VSS), D98.3 (VSS), D99.3 (VSS), D100.3 (VSS), D101.3 (VSS), D102.3 (VSS), D103.3 (VSS), D104.3 (VSS), D105.3 (VSS), D106.3 (VSS), D107.3 (VSS), D108.3 (VSS), D109.3 (VSS), D110.3 (VSS), D111.3 (VSS), D112.3 (VSS), D113.3 (VSS), D114.3 (VSS), D115.3 (VSS), D116.3 (VSS), D117.3 (VSS), D118.3 (VSS), D119.3 (VSS), D120.3 (VSS), D121.3 (VSS), D122.3 (VSS), D123.3 (VSS), D124.3 (VSS), D125.3 (VSS), D126.3 (VSS), D127.3 (VSS), D128.3 (VSS), D129.3 (VSS), D130.3 (VSS), D131.3 (VSS), D132.3 (VSS), D133.3 (VSS), D134.3 (VSS), D135.3 (VSS), D136.3 (VSS), D137.3 (VSS), D138.3 (VSS), D139.3 (VSS), D140.3 (VSS), D141.3 (VSS), D142.3 (VSS), D143.3 (VSS), D144.3 (VSS), D145.3 (VSS), D146.3 (VSS), D147.3 (VSS), D148.3 (VSS), D149.3 (VSS), D150.3 (VSS), D151.3 (VSS), D152.3 (VSS), D153.3 (VSS), D154.3 (VSS), D155.3 (VSS), D156.3 (VSS), D157.3 (VSS), D158.3 (VSS), D159.3 (VSS), D160.3 (VSS), D161.3 (VSS), D162.3 (VSS), D163.3 (VSS), D164.3 (VSS), D165.3 (VSS), D166.3 (VSS), D167.3 (VSS), D168.3 (VSS), D169.3 (VSS), D170.3 (VSS), D171.3 (VSS), D172.3 (VSS), D173.3 (VSS), D174.3 (VSS), D175.3 (VSS), D176.3 (VSS), D177.3 (VSS), D178.3 (VSS), D179.3 (VSS), D180.3 (VSS), D181.3 (VSS), D182.3 (VSS), D183.3 (VSS), D184.3 (VSS), D185.3 (VSS), D186.3 (VSS), D187.3 (VSS), D188.3 (VSS), D189.3 (VSS), D190.3 (VSS), D191.3 (VSS), D192.3 (VSS), D193.3 (VSS), D194.3 (VSS), D195.3 (VSS), D196.3 (VSS), D197.3 (VSS), D198.3 (VSS), D199.3 (VSS), D200.3 (VSS), D201.3 (VSS), D202.3 (VSS), D203.3 (VSS), D204.3 (VSS), D205.3 (VSS), D206.3 (VSS), D207.3 (VSS), D208.3 (VSS), D209.3 (VSS), D210.3 (VSS), D211.3 (VSS), D212.3 (VSS), D213.3 (VSS), D214.3 (VSS), D215.3 (VSS), D216.3 (VSS), D217.3 (VSS), D218.3 (VSS), D219.3 (VSS), D220.3 (VSS), D221.3 (VSS), D222.3 (VSS), D223.3 (VSS), D224.3 (VSS), D225.3 (VSS), D226.3 (VSS), D227.3 (VSS), D228.3 (VSS), D229.3 (VSS), D230.3 (VSS), D231.3 (VSS), D232.3 (VSS), D233.3 (VSS), D234.3 (VSS), D235.3 (VSS), D236.3 (VSS), D237.3 (VSS), D238.3 (VSS), D239.3 (VSS), D240.3 (VSS), D241.3 (VSS), D242.3 (VSS), D243.3 (VSS), D244.3 (VSS), D245.3 (VSS), D246.3 (VSS), D247.3 (VSS), D248.3 (VSS), D249.3 (VSS), D250.3 (VSS), D251.3 (VSS), D252.3 (VSS), D253.3 (VSS), D254.3 (VSS), D255.3 (VSS), D256.3 (VSS), J2.1, J4.1, J6.1, J8.1, J10.1, J12.1, U1.1, U1.3 (GND)

Notes on the sheet:
WS2812B Matrix 16x16, Raster 10 mm, 2 Lagen - Datenkette D1 -> D256 als Serpentine, Anordnung wie auf der Platine
Eingang: 3,3V-Daten -> Pegelwandler -> D1 | Ausgang D256 -> J3 | Einspeisung +5V/GND (Unterseite)

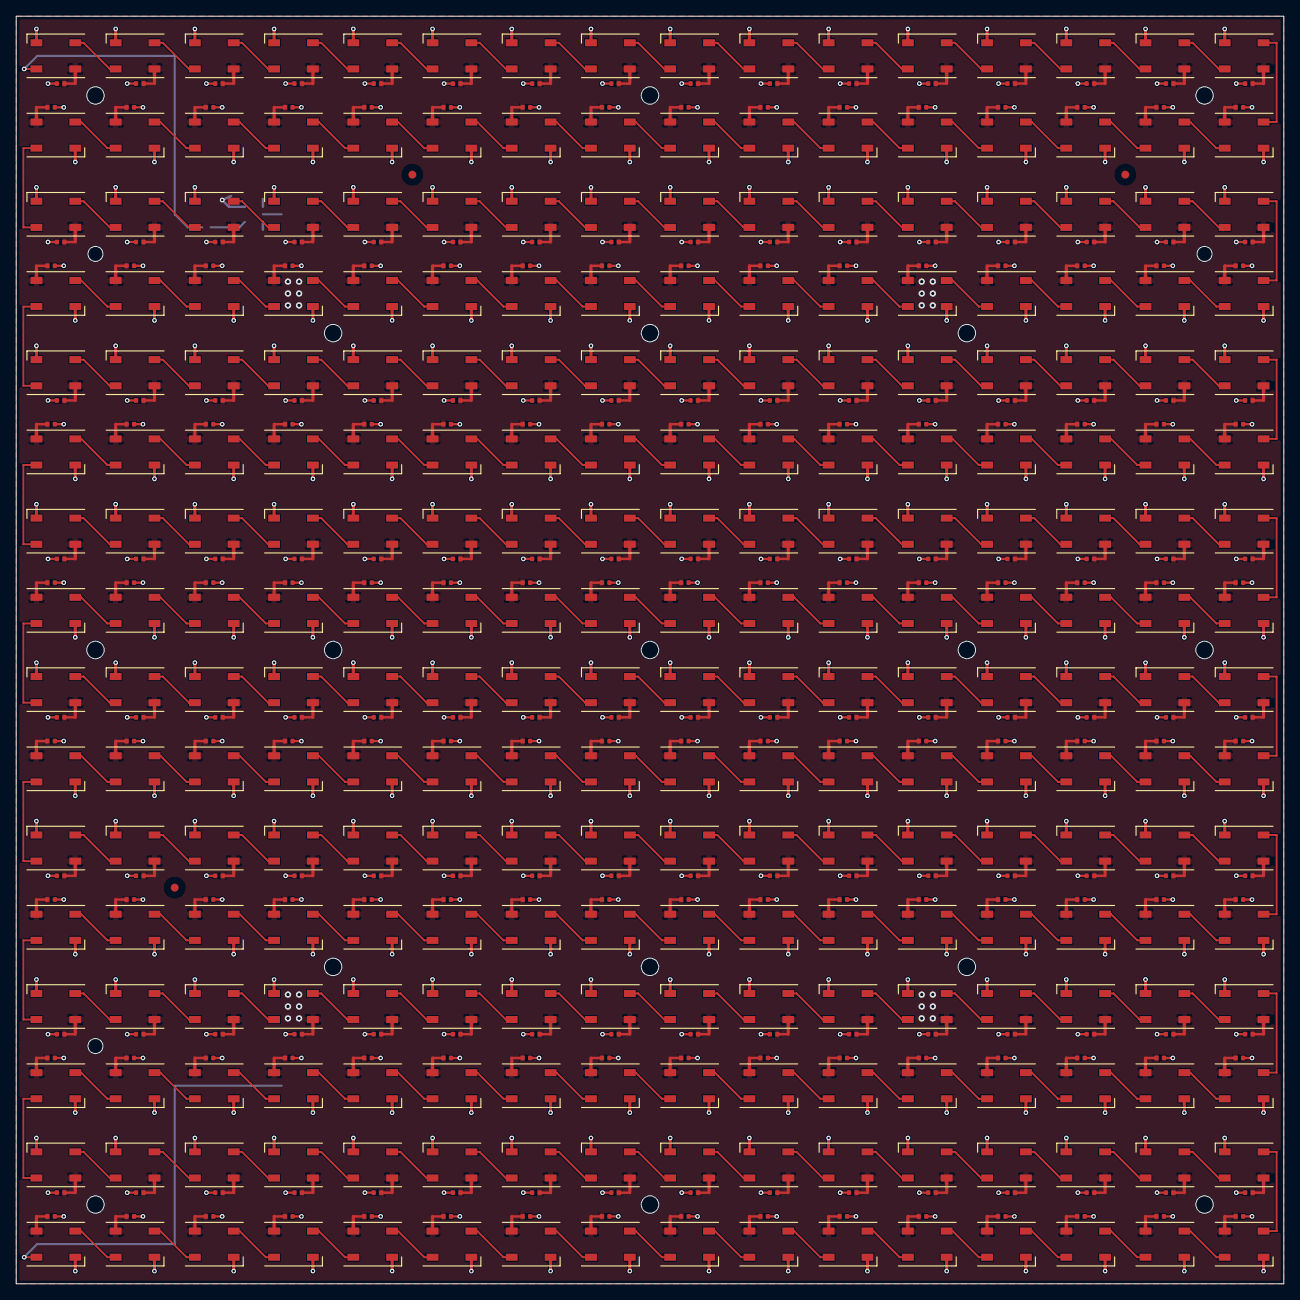
[picture p11: board LED_Matrix_16x16_2L.kicad_pcb from above]

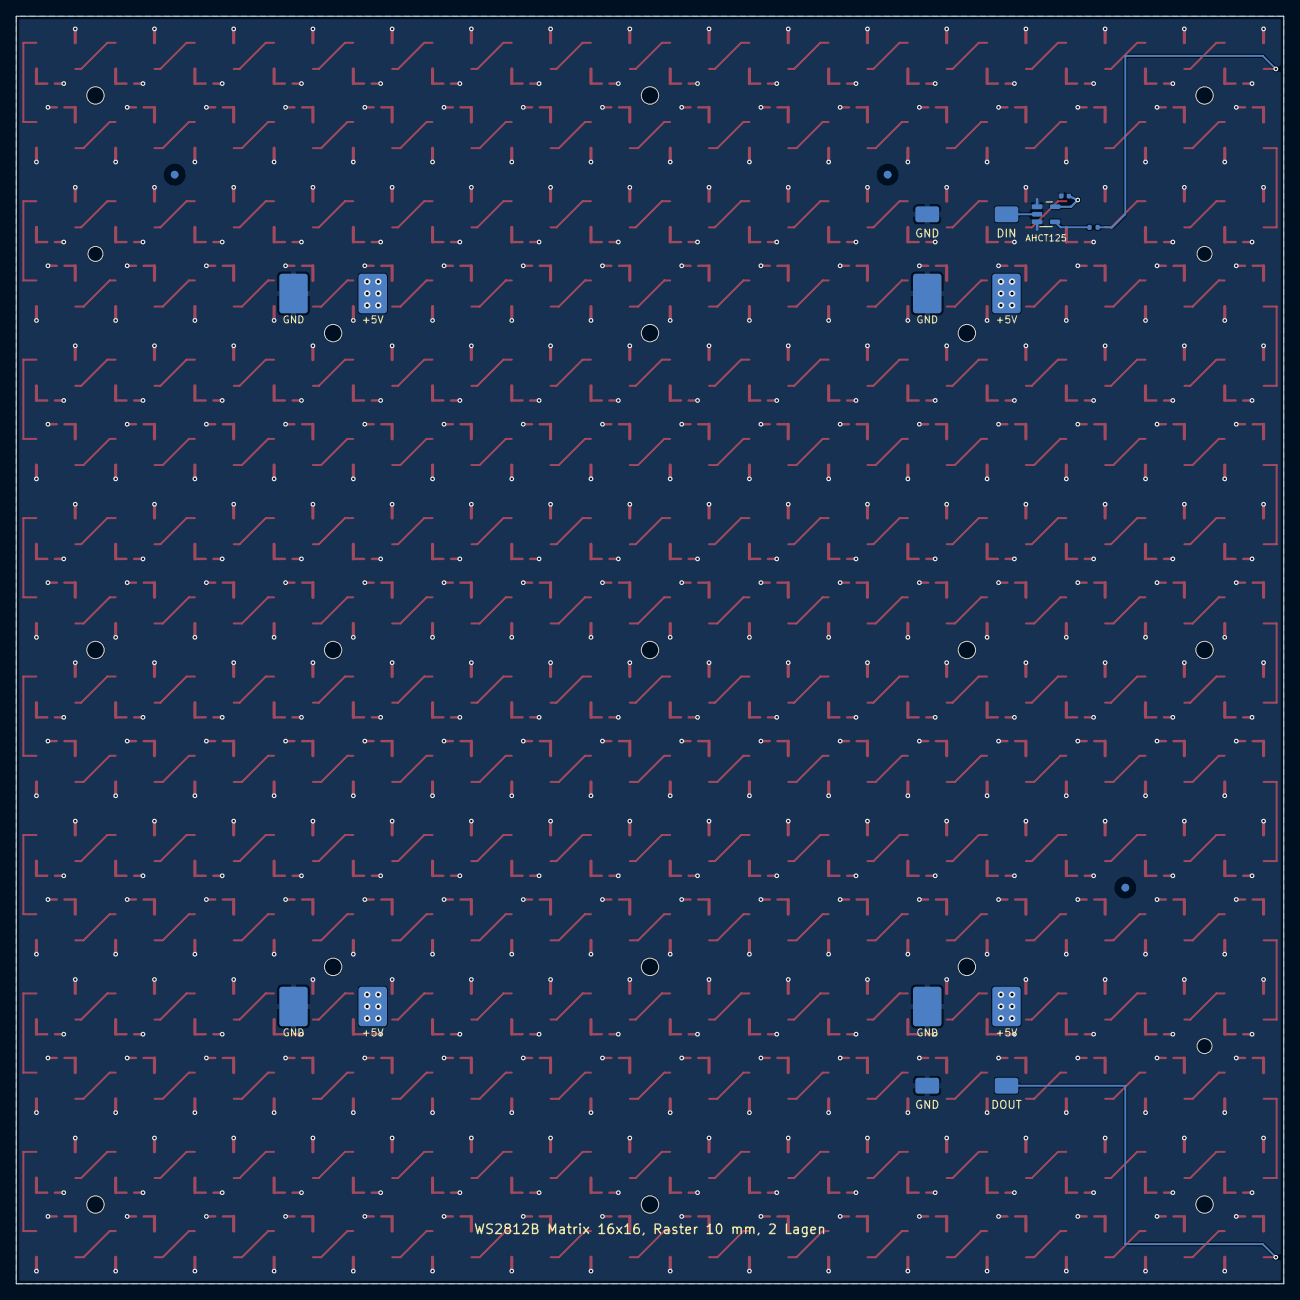
[picture p12: board LED_Matrix_16x16_2L.kicad_pcb from below]

Board: 2 copper layers, 160.0 x 160.0 mm, 553 parts (18 on the bottom side), 261 nets.
