Vindaomeo/retropixel/script/mx8/font5x7.py

"""5x7 bitmap font for the 8x8 matrix.

The glyphs are deliberately written as ASCII art in the source, not as a hex table:
that way you see at a glance which letter it is, and a typo stands out while
skimming the code instead of only on the panel.

    "A": (".###.",
          "#...#",
          ...)

`#` = pixel on, anything else = off. Each glyph is 5 wide and 7 high.
On an 8-pixel-high display that leaves one row of headroom at the top/bottom.
"""

from __future__ import annotations

GLYPH_W = 5
GLYPH_H = 7

# fmt: off
GLYPHS: dict[str, tuple[str, ...]] = {
    " ": (".....", ".....", ".....", ".....", ".....", ".....", "....."),
    "!": ("..#..", "..#..", "..#..", "..#..", "..#..", ".....", "..#.."),
    '"': (".#.#.", ".#.#.", ".....", ".....", ".....", ".....", "....."),
    "#": (".#.#.", ".#.#.", "#####", ".#.#.", "#####", ".#.#.", ".#.#."),
    "$": ("..#..", ".####", "#.#..", ".###.", "..#.#", "####.", "..#.."),
    "%": ("##...", "##..#", "...#.", "..#..", ".#...", "#..##", "...##"),
    "&": (".##..", "#..#.", "#.#..", ".#...", "#.#.#", "#..#.", ".##.#"),
    "'": ("..#..", "..#..", ".....", ".....", ".....", ".....", "....."),
    "(": ("...#.", "..#..", ".#...", ".#...", ".#...", "..#..", "...#."),
    ")": (".#...", "..#..", "...#.", "...#.", "...#.", "..#..", ".#..."),
    "*": (".....", "#.#.#", ".###.", "#####", ".###.", "#.#.#", "....."),
    "+": (".....", "..#..", "..#..", "#####", "..#..", "..#..", "....."),
    ",": (".....", ".....", ".....", ".....", ".....", "..##.", "..#.."),
    "-": (".....", ".....", ".....", "#####", ".....", ".....", "....."),
    ".": (".....", ".....", ".....", ".....", ".....", ".##..", ".##.."),
    "/": ("....#", "...#.", "...#.", "..#..", ".#...", ".#...", "#...."),
    "0": (".###.", "#...#", "#..##", "#.#.#", "##..#", "#...#", ".###."),
    "1": ("..#..", ".##..", "..#..", "..#..", "..#..", "..#..", ".###."),
    "2": (".###.", "#...#", "....#", "...#.", "..#..", ".#...", "#####"),
    "3": ("#####", "...#.", "..#..", "...#.", "....#", "#...#", ".###."),
    "4": ("...#.", "..##.", ".#.#.", "#..#.", "#####", "...#.", "...#."),
    "5": ("#####", "#....", "####.", "....#", "....#", "#...#", ".###."),
    "6": ("..##.", ".#...", "#....", "####.", "#...#", "#...#", ".###."),
    "7": ("#####", "....#", "...#.", "..#..", ".#...", ".#...", ".#..."),
    "8": (".###.", "#...#", "#...#", ".###.", "#...#", "#...#", ".###."),
    "9": (".###.", "#...#", "#...#", ".####", "....#", "...#.", ".##.."),
    ":": (".....", ".##..", ".##..", ".....", ".##..", ".##..", "....."),
    ";": (".....", ".##..", ".##..", ".....", ".##..", "..#..", ".#..."),
    "<": ("...#.", "..#..", ".#...", "#....", ".#...", "..#..", "...#."),
    "=": (".....", ".....", "#####", ".....", "#####", ".....", "....."),
    ">": (".#...", "..#..", "...#.", "....#", "...#.", "..#..", ".#..."),
    "?": (".###.", "#...#", "....#", "...#.", "..#..", ".....", "..#.."),
    "@": (".###.", "#...#", "#.###", "#.#.#", "#.###", "#....", ".###."),
    "A": (".###.", "#...#", "#...#", "#####", "#...#", "#...#", "#...#"),
    "B": ("####.", "#...#", "#...#", "####.", "#...#", "#...#", "####."),
    "C": (".###.", "#...#", "#....", "#....", "#....", "#...#", ".###."),
    "D": ("###..", "#..#.", "#...#", "#...#", "#...#", "#..#.", "###.."),
    "E": ("#####", "#....", "#....", "####.", "#....", "#....", "#####"),
    "F": ("#####", "#....", "#....", "####.", "#....", "#....", "#...."),
    "G": (".###.", "#...#", "#....", "#..##", "#...#", "#...#", ".####"),
    "H": ("#...#", "#...#", "#...#", "#####", "#...#", "#...#", "#...#"),
    "I": (".###.", "..#..", "..#..", "..#..", "..#..", "..#..", ".###."),
    "J": ("....#", "....#", "....#", "....#", "#...#", "#...#", ".###."),
    "K": ("#...#", "#..#.", "#.#..", "##...", "#.#..", "#..#.", "#...#"),
    "L": ("#....", "#....", "#....", "#....", "#....", "#....", "#####"),
    "M": ("#...#", "##.##", "#.#.#", "#.#.#", "#...#", "#...#", "#...#"),
    "N": ("#...#", "##..#", "##..#", "#.#.#", "#..##", "#..##", "#...#"),
    "O": (".###.", "#...#", "#...#", "#...#", "#...#", "#...#", ".###."),
    "P": ("####.", "#...#", "#...#", "####.", "#....", "#....", "#...."),
    "Q": (".###.", "#...#", "#...#", "#...#", "#.#.#", "#..#.", ".##.#"),
    "R": ("####.", "#...#", "#...#", "####.", "#.#..", "#..#.", "#...#"),
    "S": (".####", "#....", "#....", ".###.", "....#", "....#", "####."),
    "T": ("#####", "..#..", "..#..", "..#..", "..#..", "..#..", "..#.."),
    "U": ("#...#", "#...#", "#...#", "#...#", "#...#", "#...#", ".###."),
    "V": ("#...#", "#...#", "#...#", "#...#", "#...#", ".#.#.", "..#.."),
    "W": ("#...#", "#...#", "#...#", "#.#.#", "#.#.#", "##.##", "#...#"),
    "X": ("#...#", "#...#", ".#.#.", "..#..", ".#.#.", "#...#", "#...#"),
    "Y": ("#...#", "#...#", ".#.#.", "..#..", "..#..", "..#..", "..#.."),
    "Z": ("#####", "....#", "...#.", "..#..", ".#...", "#....", "#####"),
    "[": (".###.", ".#...", ".#...", ".#...", ".#...", ".#...", ".###."),
    "\\": ("#....", ".#...", ".#...", "..#..", "...#.", "...#.", "....#"),
    "]": (".###.", "...#.", "...#.", "...#.", "...#.", "...#.", ".###."),
    "^": ("..#..", ".#.#.", "#...#", ".....", ".....", ".....", "....."),
    "_": (".....", ".....", ".....", ".....", ".....", ".....", "#####"),
    "`": (".#...", "..#..", ".....", ".....", ".....", ".....", "....."),
    "a": (".....", ".....", ".###.", "....#", ".####", "#...#", ".####"),
    "b": ("#....", "#....", "####.", "#...#", "#...#", "#...#", "####."),
    "c": (".....", ".....", ".###.", "#....", "#....", "#...#", ".###."),
    "d": ("....#", "....#", ".####", "#...#", "#...#", "#...#", ".####"),
    "e": (".....", ".....", ".###.", "#...#", "#####", "#....", ".###."),
    "f": ("..##.", ".#..#", ".#...", "###..", ".#...", ".#...", ".#..."),
    "g": (".....", ".####", "#...#", "#...#", ".####", "....#", ".###."),
    "h": ("#....", "#....", "####.", "#...#", "#...#", "#...#", "#...#"),
    "i": ("..#..", ".....", ".##..", "..#..", "..#..", "..#..", ".###."),
    "j": ("...#.", ".....", "..##.", "...#.", "...#.", "#..#.", ".##.."),
    "k": ("#....", "#....", "#..#.", "#.#..", "##...", "#.#..", "#..#."),
    "l": (".##..", "..#..", "..#..", "..#..", "..#..", "..#..", ".###."),
    "m": (".....", ".....", "##.#.", "#.#.#", "#.#.#", "#...#", "#...#"),
    "n": (".....", ".....", "####.", "#...#", "#...#", "#...#", "#...#"),
    "o": (".....", ".....", ".###.", "#...#", "#...#", "#...#", ".###."),
    "p": (".....", "####.", "#...#", "#...#", "####.", "#....", "#...."),
    "q": (".....", ".####", "#...#", "#...#", ".####", "....#", "....#"),
    "r": (".....", ".....", "#.##.", "##..#", "#....", "#....", "#...."),
    "s": (".....", ".....", ".####", "#....", ".###.", "....#", "####."),
    "t": (".#...", ".#...", "###..", ".#...", ".#...", ".#..#", "..##."),
    "u": (".....", ".....", "#...#", "#...#", "#...#", "#..##", ".##.#"),
    "v": (".....", ".....", "#...#", "#...#", "#...#", ".#.#.", "..#.."),
    "w": (".....", ".....", "#...#", "#...#", "#.#.#", "#.#.#", ".#.#."),
    "x": (".....", ".....", "#...#", ".#.#.", "..#..", ".#.#.", "#...#"),
    "y": (".....", "#...#", "#...#", "#...#", ".####", "....#", ".###."),
    "z": (".....", ".....", "#####", "...#.", "..#..", ".#...", "#####"),
    "{": ("...##", "..#..", "..#..", ".#...", "..#..", "..#..", "...##"),
    "|": ("..#..", "..#..", "..#..", "..#..", "..#..", "..#..", "..#.."),
    "}": ("##...", "..#..", "..#..", "...#.", "..#..", "..#..", "##..."),
    "~": (".....", ".....", ".#..#", "#.#.#", "#..#.", ".....", "....."),
    # Umlauts and eszett -- without them every German text looks ugly
    "Ä": ("#...#", ".###.", "#...#", "#####", "#...#", "#...#", "#...#"),
    "Ö": ("#...#", ".###.", "#...#", "#...#", "#...#", "#...#", ".###."),
    "Ü": ("#...#", ".....", "#...#", "#...#", "#...#", "#...#", ".###."),
    "ä": (".#.#.", ".....", ".###.", "....#", ".####", "#...#", ".####"),
    "ö": (".#.#.", ".....", ".###.", "#...#", "#...#", "#...#", ".###."),
    "ü": (".#.#.", ".....", "#...#", "#...#", "#...#", "#..##", ".##.#"),
    "ß": (".##..", "#..#.", "#..#.", "#.#..", "#..#.", "#..#.", "#.##."),
    "°": (".##..", "#..#.", ".##..", ".....", ".....", ".....", "....."),
}
# fmt: on

FALLBACK = GLYPHS["?"]


def glyph(ch: str) -> tuple[str, ...]:
    """Bitmap of a glyph. Unknown characters become '?'."""
    return GLYPHS.get(ch, FALLBACK)


class TextBitmap:
    """A rendered run of text as a column bitmask.

    Internally a list of columns, each column a list of 7 bools. That makes
    horizontal scrolling just an index offset instead of a recomputation.
    """

    __slots__ = ("cols", "height")

    def __init__(self, text: str, spacing: int = 1) -> None:
        self.height = GLYPH_H
        self.cols: list[list[bool]] = []
        for i, ch in enumerate(text):
            rows = glyph(ch)
            for x in range(GLYPH_W):
                self.cols.append([rows[y][x] == "#" for y in range(GLYPH_H)])
            if i != len(text) - 1:
                for _ in range(spacing):
                    self.cols.append([False] * GLYPH_H)

    def __len__(self) -> int:
        return len(self.cols)

    def column(self, x: int) -> list[bool]:
        """Column x; an empty column outside the text."""
        if 0 <= x < len(self.cols):
            return self.cols[x]
        return [False] * self.height

    def to_ascii(self) -> str:
        """For a quick look in the terminal."""
        return "\n".join(
            "".join("#" if self.cols[x][y] else "." for x in range(len(self.cols)))
            for y in range(self.height)
        )


def validate_font() -> list[str]:
    """Checks the glyph table for shape errors. Empty list = all good."""
    problems = []
    for ch, rows in GLYPHS.items():
        if len(rows) != GLYPH_H:
            problems.append(f"{ch!r}: {len(rows)} rows instead of {GLYPH_H}")
        for i, r in enumerate(rows):
            if len(r) != GLYPH_W:
                problems.append(f"{ch!r} row {i}: {len(r)} characters instead of {GLYPH_W}")
            if set(r) - {"#", "."}:
                problems.append(f"{ch!r} row {i}: invalid characters {set(r) - {'#', '.'}!r}")
    return problems
