Vindaomeo/retropixel/(commit log)

2026-08-16 rename for arduino compile
2026-10-02 now with fiducials
    [LED_Matrix_16x16_2L.kicad_pcb, LED_Matrix_16x16_2L.kicad_sch, LED_Matrix_16x16_2L_BOM.csv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]
2026-10-02 added lightguards.stl
    [LED_Matrix_16x16_2L.kicad_pcb, LED_Matrix_16x16_Lichtgitter.stl, bom.csv, designators.csv, positions.csv]
2026-10-02 generated on lightguide
    [LED_Matrix_16x16_2L.kicad_pcb, LED_Matrix_16x16_2L.step]
2026-10-02 now with domes
    [LED_Matrix_16x16_2L.kicad_pcb, LED_Matrix_16x16_2L.kicad_sch, LED_Matrix_16x16_2L_BOM.csv, LED_Matrix_16x16_Lichtgitter.stl, LED_Matrix_16x16_Lichtgitter_Test3x3.stl, LED_Matrix_16x16_Rahmen.stl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]
2026-11-04 chore(pcb): stop tracking KiCad local history, backups and caches
    - remove embedded .history git repo (was tracked as a broken submodule)
    - remove automatic backup zip, fp-info-cache and per-user .kicad_prl files
    - extend .gitignore with a KiCad section
2026-11-04 pcb(frame): update KiCad project settings of frame board
2026-11-04 docs: convert HTML guides to Markdown
    - docs/pixelgrid.html -> docs/pixelgrid.md
    - docs/wiring.html -> docs/wiring.md
    - diagrams extracted as standalone SVGs into docs/img/ so GitHub renders them
    - update links in README.md and WIRING.md
2026-11-04 fix: default brightness 30 for USB-powered 8x8 setup
    USB 2.0 delivers 500 mA; at brightness 30/255 a full-white 8x8 frame stays
    within budget. Firmware defaults (8x8 board and custom fallback) were 40
    and the docs were inconsistent. Align firmware, WIRING.md and docs/wiring.md.
    [mx8_config.h]
